Ak-yerr/Automatic-Dog-Door-Project-PLTW/Photos/Final_chassis_design.jpg

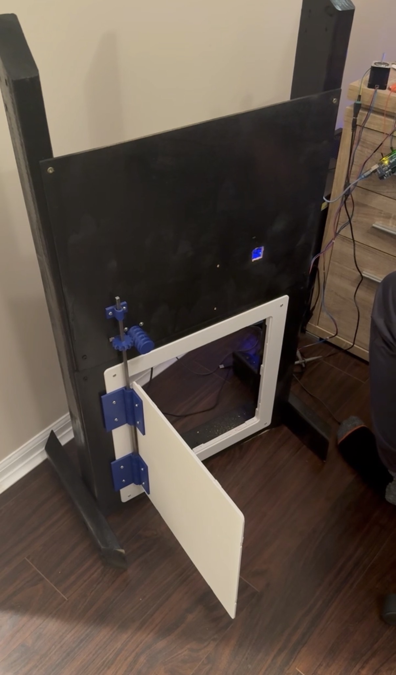
Photos/Final_chassis_design.jpg
