Ak-yerr/Automatic-Dog-Door-Project-PLTW/Photos/circuit_image.png

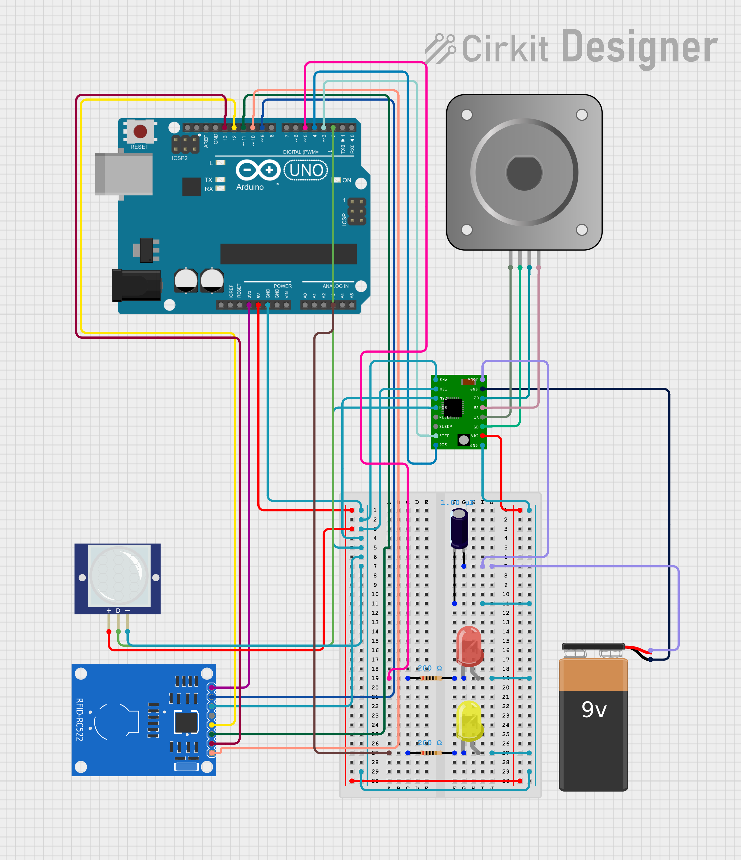
Photos/circuit_image.png
