Ak-yerr/Automatic-Dog-Door-Project-PLTW/Photos/Front_side_final.jpeg

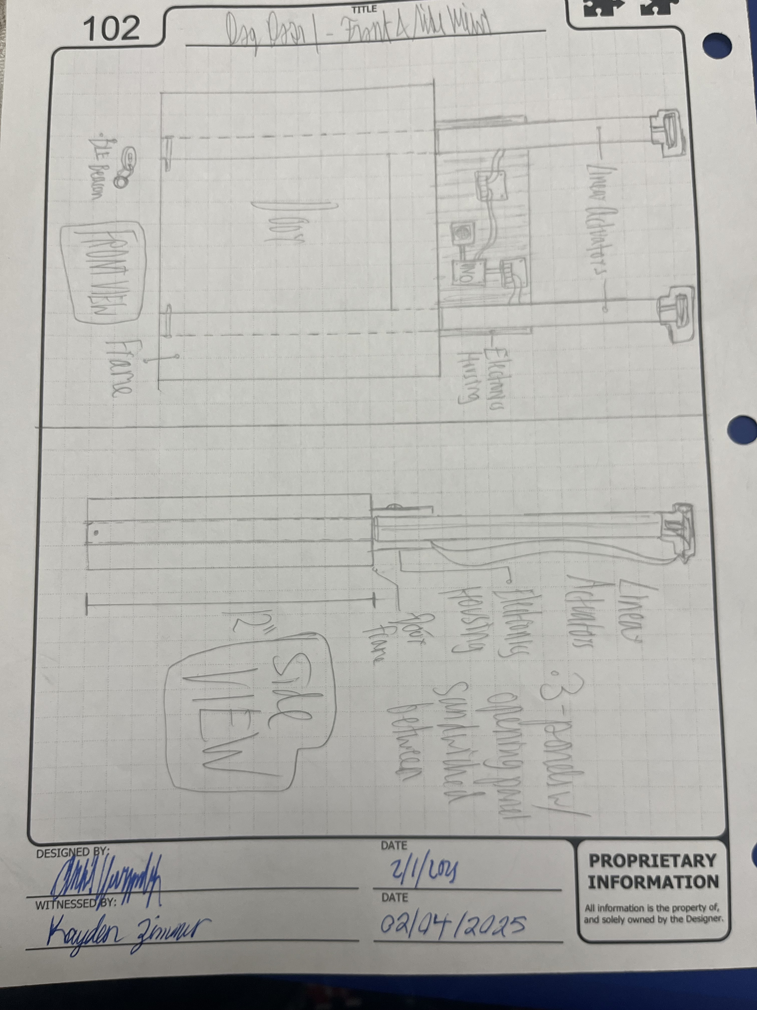
Photos/Front_side_final.jpeg
