Ak-yerr/Automatic-Dog-Door-Project-PLTW/Photos/Init_sketches.jpeg

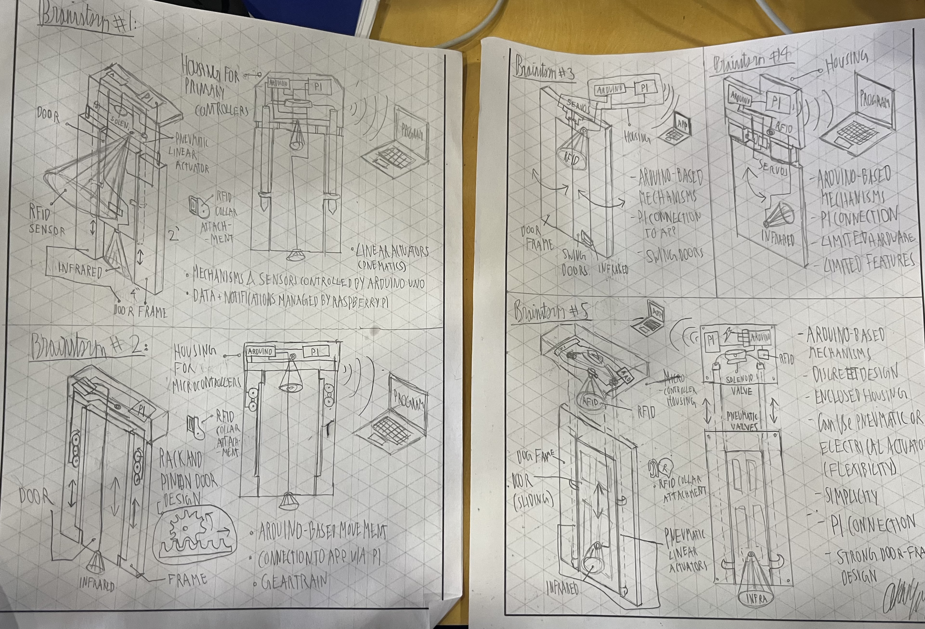
Photos/Init_sketches.jpeg
