Ak-yerr/Automatic-Dog-Door-Project-PLTW/Photos/Team_presentation.jpeg

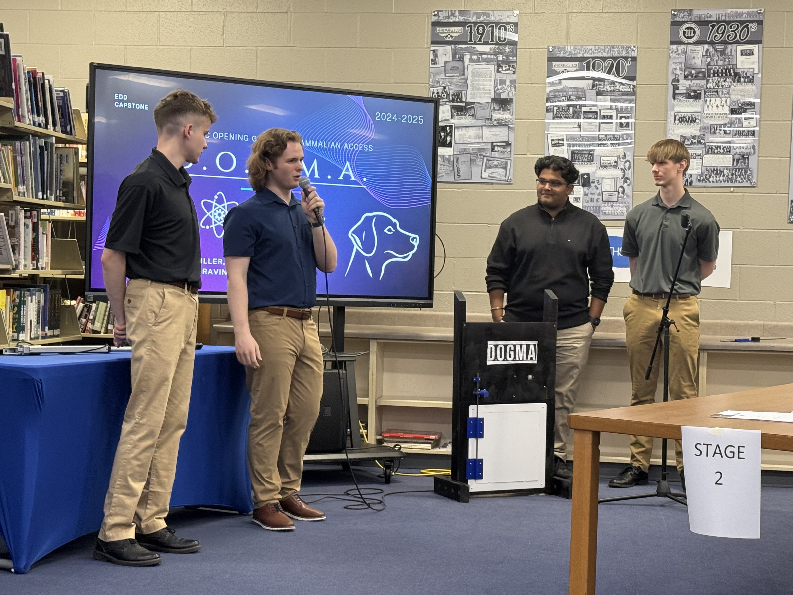
Photos/Team_presentation.jpeg
