Ak-yerr/Automatic-Dog-Door-Project-PLTW/(commit log)

2026-06-20 Added picture of physical electronics wiring
2026-06-21 Added photo of prototype's front profile
