Ak-yerr/Automatic-Dog-Door-Project-PLTW/Photos/Isometric_final.jpeg

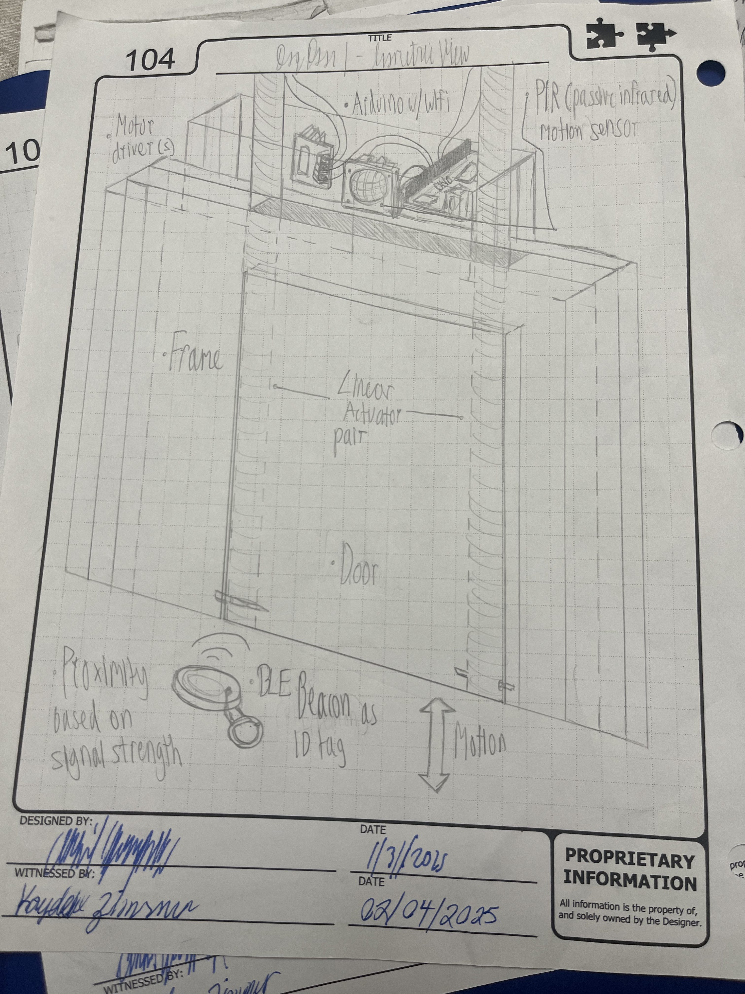
Photos/Isometric_final.jpeg
