Ak-yerr/Automatic-Dog-Door-Project-PLTW/Photos/Prototype_front.jpeg

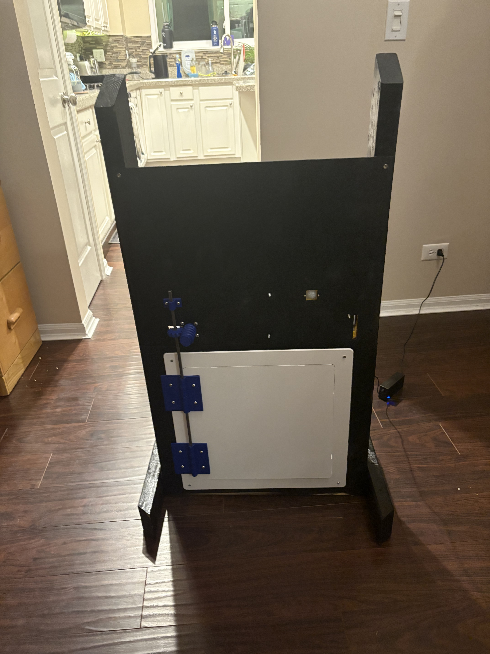
Photos/Prototype_front.jpeg
